phorton1/Arduino-theClock/docs/kicad/pcb1.1/pcb1.1.step

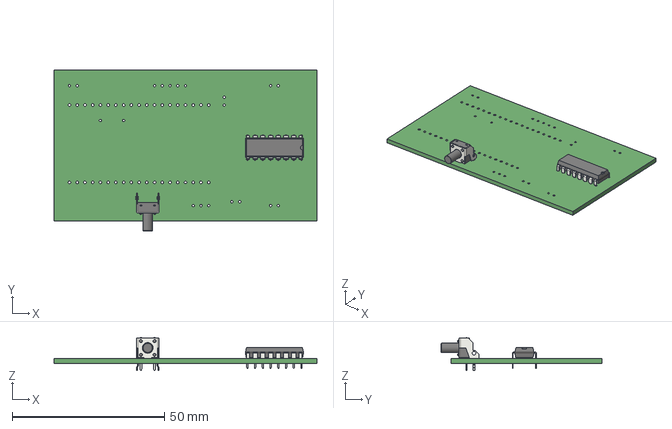
[picture p10: CAD file, 2022-12-11]
docs/kicad/pcb1.1/pcb1.1.step
86.4 x 52.7 x 11.0 mm
