phorton1/Arduino-theClock/docs/kicad/pcb2.0/pcb_v2.step

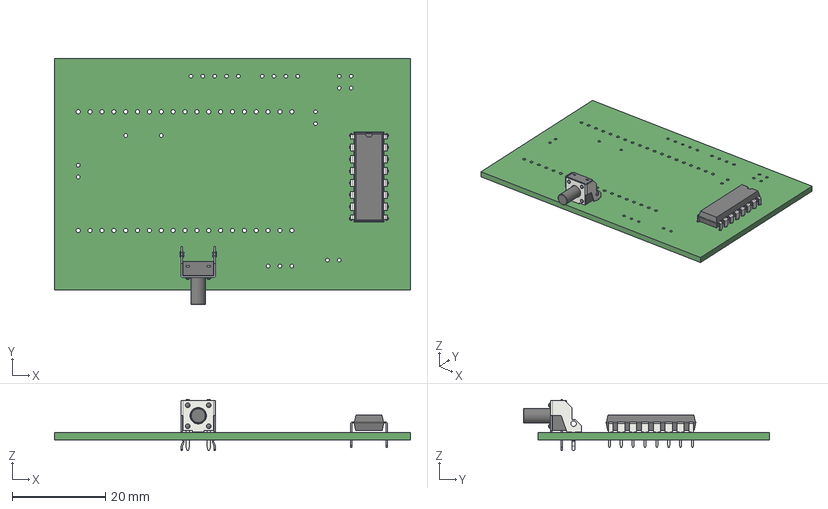
[picture p11: CAD file, 2022-11-30]
docs/kicad/pcb2.0/pcb_v2.step
76.2 x 52.7 x 11.0 mm
