phorton1/Arduino-theClock/docs/version2.0/dxf/minutes_hand.dxf

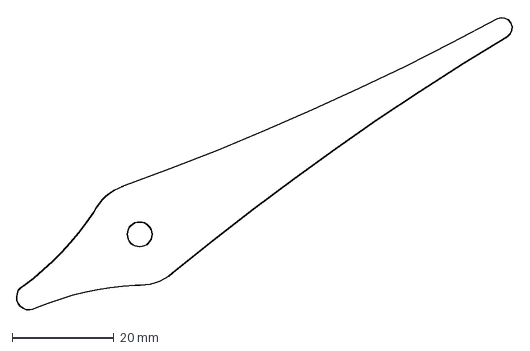
[picture p12: CAD file, 2023-06-12]
docs/version2.0/dxf/minutes_hand.dxf
97.8 x 57.9 mm
