phorton1/Arduino-theClock/docs/version2.0/plastic/coil_set.3mf

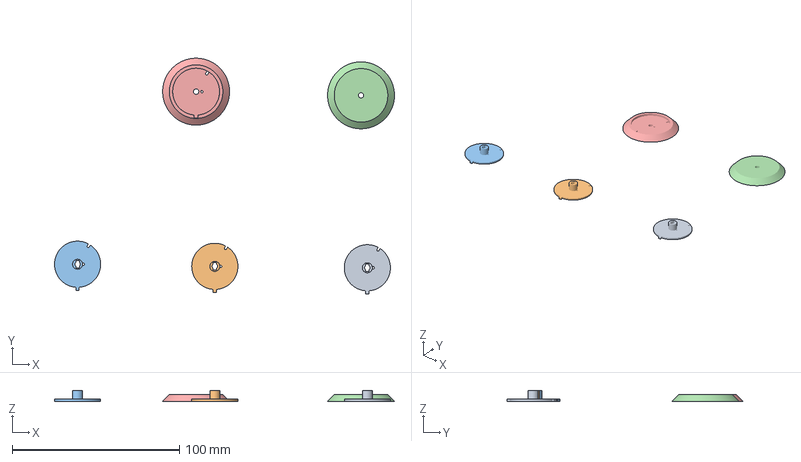
[picture p13: CAD file, 2023-06-12]
docs/version2.0/plastic/coil_set.3mf
203.2 x 140.8 x 6.30 mm
coil_bobbin.stl x 3
coil_tool_front.stl
coil_tool_back.stl
