phorton1/Arduino-theClock/docs/version2.0/dxf/secs_wheel.dxf

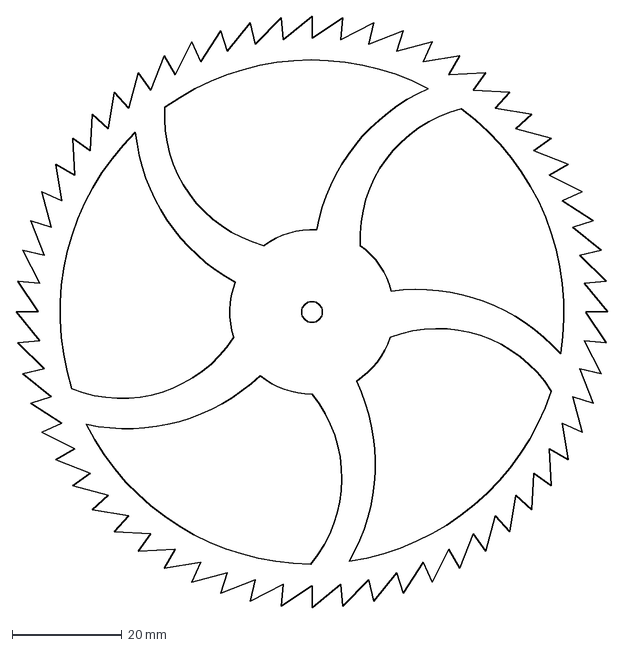
[picture p14: CAD file, 2023-06-12]
docs/version2.0/dxf/secs_wheel.dxf
108.0 x 108.0 mm
