phorton1/Arduino-theClock/docs/version2.0/plastic/plastic_pawl_spacer.stl

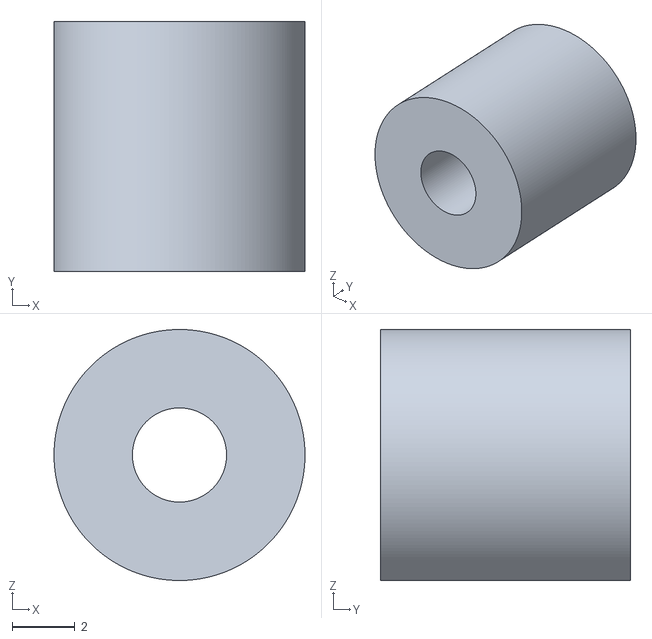
[picture p15: CAD file, 2023-06-12]
docs/version2.0/plastic/plastic_pawl_spacer.stl
8.00 x 7.98 x 8.00
