phorton1/Arduino-theClock/docs/version2.0/dxf/hours_hand.dxf

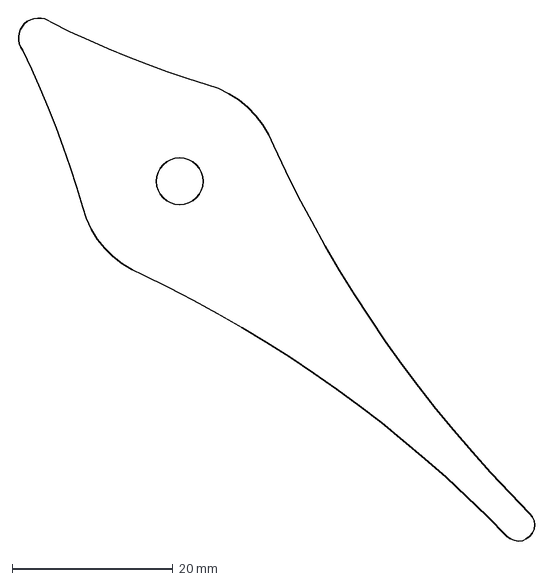
[picture p16: CAD file, 2023-06-12]
docs/version2.0/dxf/hours_hand.dxf
64.5 x 65.4 mm
