phorton1/Arduino-theClock/docs/version2.0/plastic/coil_tool_back.stl

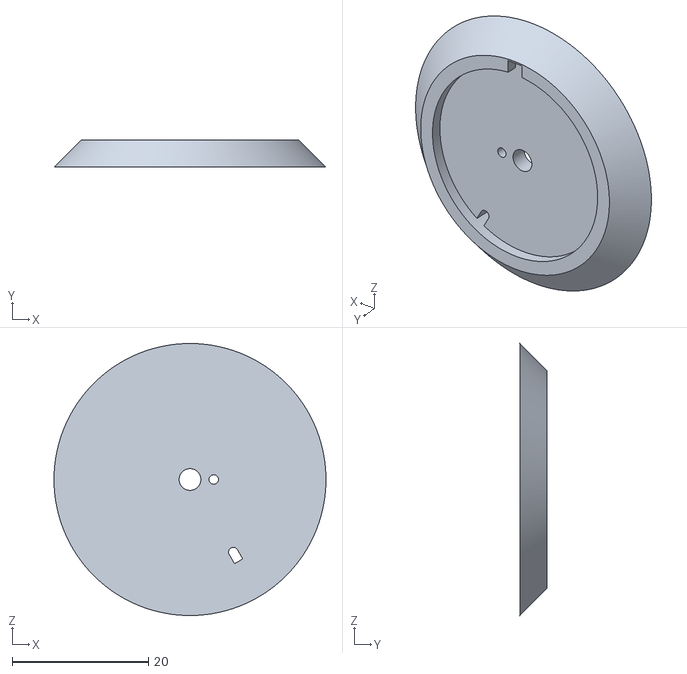
[picture p17: CAD file, 2023-06-12]
docs/version2.0/plastic/coil_tool_back.stl
40.0 x 4.00 x 40.0
