phorton1/Arduino-theClock/docs/version2.0/dxf/seconds_hand.dxf

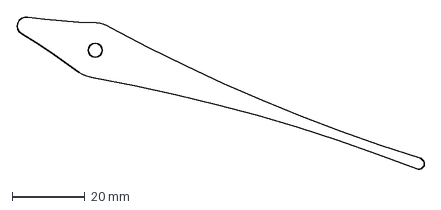
[picture p18: CAD file, 2023-06-12]
docs/version2.0/dxf/seconds_hand.dxf
111.9 x 42.0 mm
