phorton1/Arduino-theClock/docs/version2.0/plastic/coil_bobbin.stl

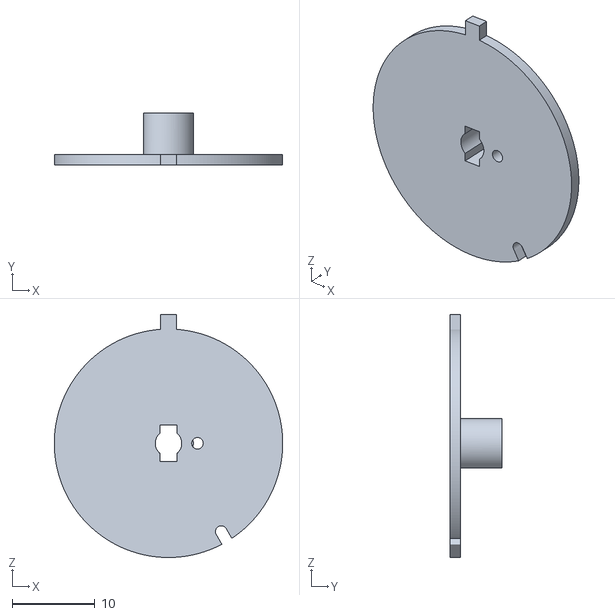
[picture p19: CAD file, 2023-06-12]
docs/version2.0/plastic/coil_bobbin.stl
27.6 x 6.30 x 29.4
