phorton1/Arduino-theClock/docs/version2.0/dxf/arm.dxf

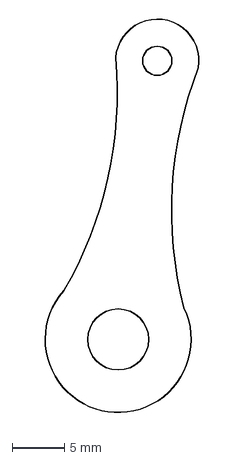
[picture p20: CAD file, 2023-06-12]
docs/version2.0/dxf/arm.dxf
15.5 x 38.8 mm
