phorton1/Arduino-theClock/docs/version2.0/plastic/plastic_box.3mf

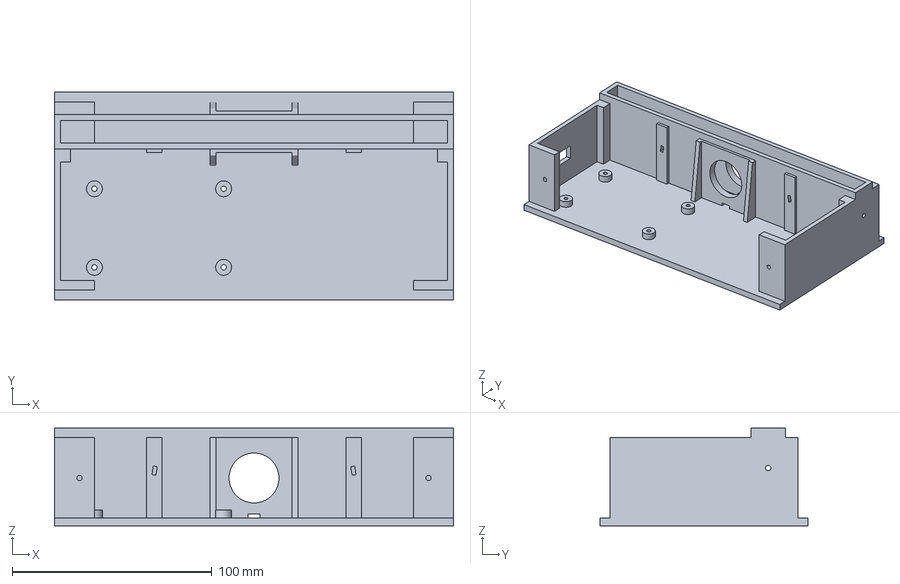
[picture p21: CAD file, 2023-06-12]
docs/version2.0/plastic/plastic_box.3mf
200.0 x 104.3 x 49.0 mm
