phorton1/Arduino-theClock/docs/version2.0/dxf/gear2b_60x2.5735.dxf

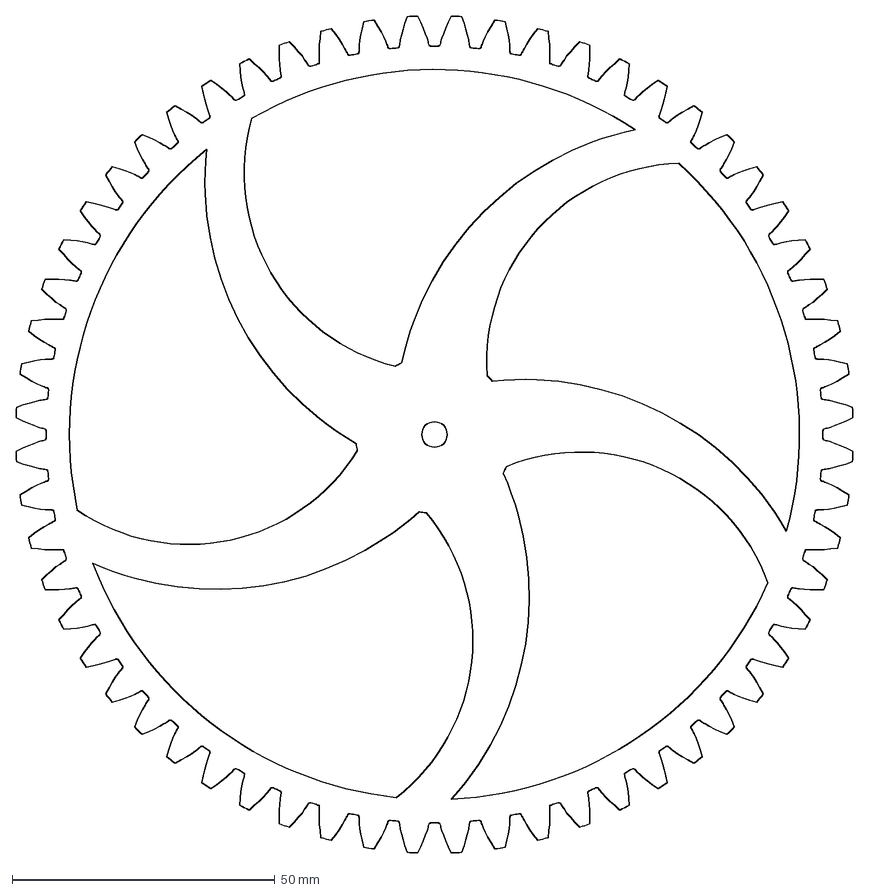
[picture p22: CAD file, 2023-06-12]
docs/version2.0/dxf/gear2b_60x2.5735.dxf
159.4 x 159.4 mm
