phorton1/Arduino-theClock/docs/version2.0/plastic/lens_cap.3mf

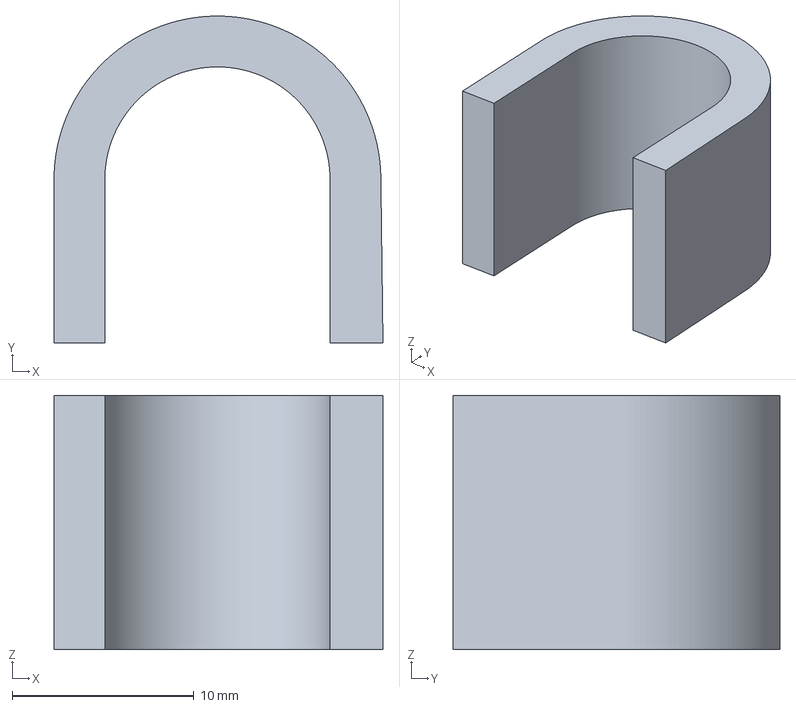
[picture p23: CAD file, 2023-06-12]
docs/version2.0/plastic/lens_cap.3mf
18.1 x 18.0 x 14.0 mm
