phorton1/Arduino-theClock/docs/version2.0/dxf/gear2a_8x2.5735.dxf

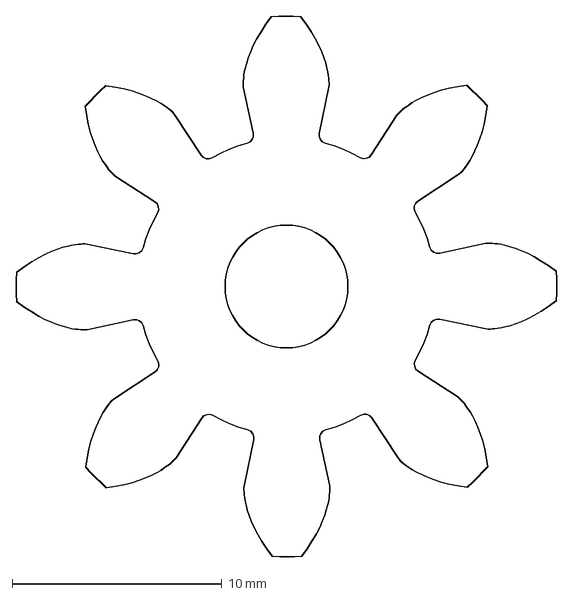
[picture p24: CAD file, 2023-06-12]
docs/version2.0/dxf/gear2a_8x2.5735.dxf
25.8 x 25.8 mm
