phorton1/Arduino-theClock/docs/version2.0/plastic/mag_slider.stl

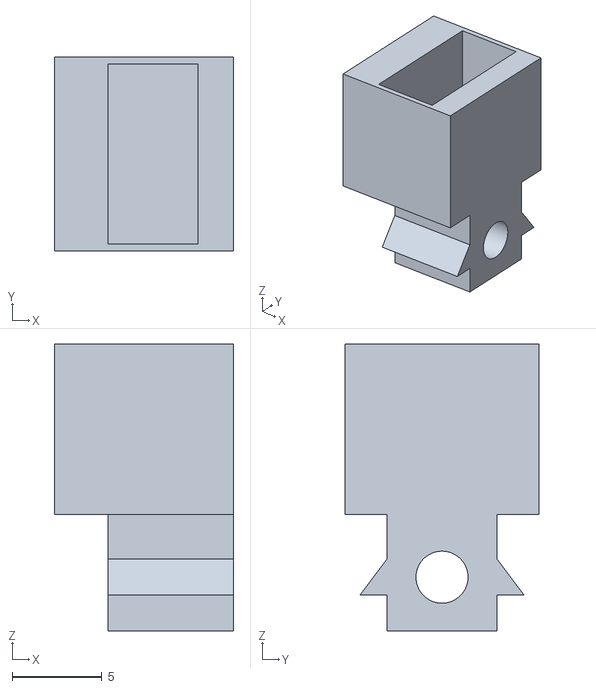
[picture p25: CAD file, 2023-06-12]
docs/version2.0/plastic/mag_slider.stl
10.0 x 10.8 x 16.0
