phorton1/Arduino-theClock/docs/version2.0/dxf/face_numbers.dxf

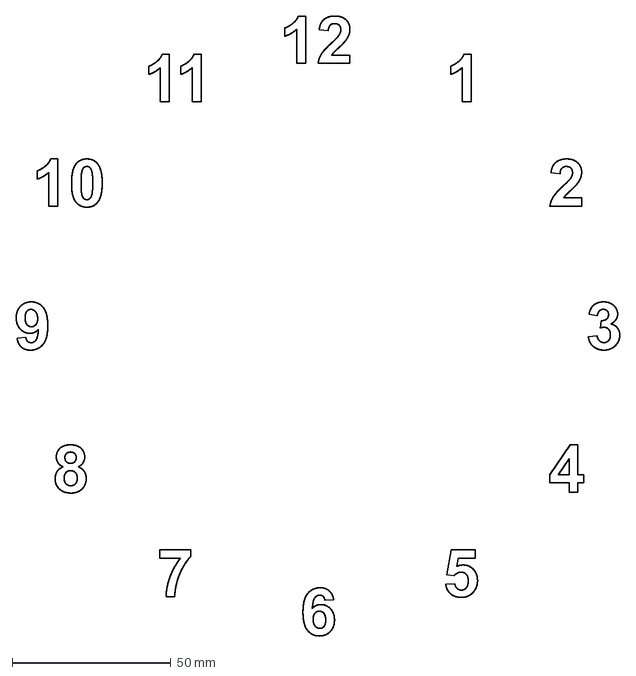
[picture p26: CAD file, 2023-06-12]
docs/version2.0/dxf/face_numbers.dxf
190.0 x 195.2 mm
