phorton1/Arduino-theClock/docs/version2.0/dxf/face.dxf

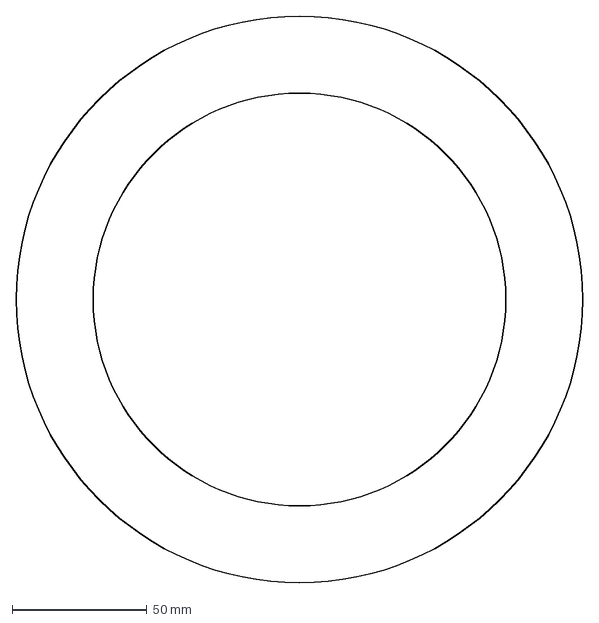
[picture p27: CAD file, 2023-06-12]
docs/version2.0/dxf/face.dxf
210.0 x 210.0 mm
