phorton1/Arduino-theClock/docs/version2.0/plastic/mag_slider_base.stl

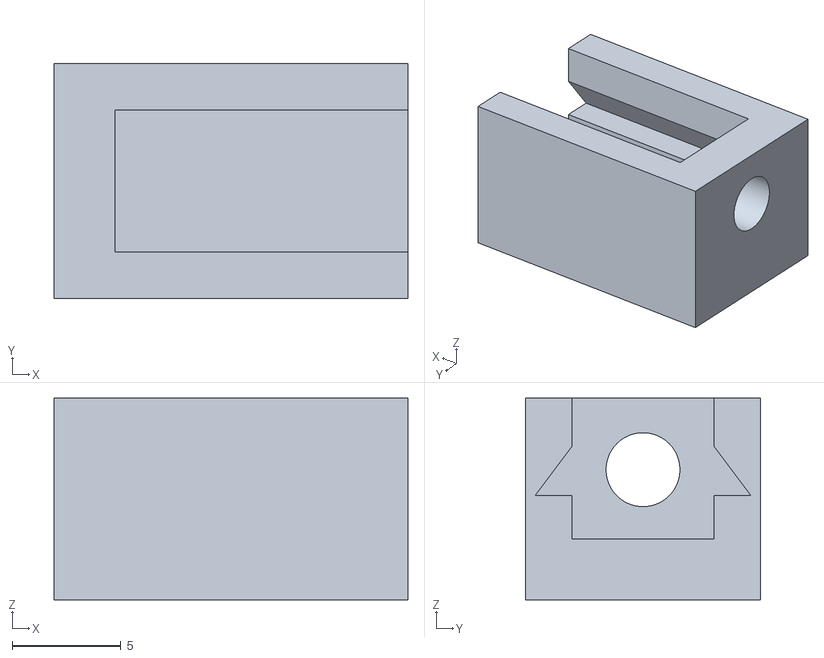
[picture p28: CAD file, 2023-06-12]
docs/version2.0/plastic/mag_slider_base.stl
16.3 x 10.8 x 9.30
