phorton1/Arduino-theClock/docs/version2.0/dxf/pawls.dxf

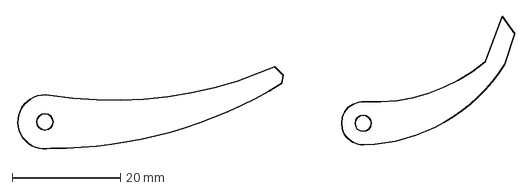
[picture p29: CAD file, 2023-06-12]
docs/version2.0/dxf/pawls.dxf
92.1 x 24.8 mm
