phorton1/Arduino-theClock/docs/version2.0/plastic/mag_slider_set.3mf

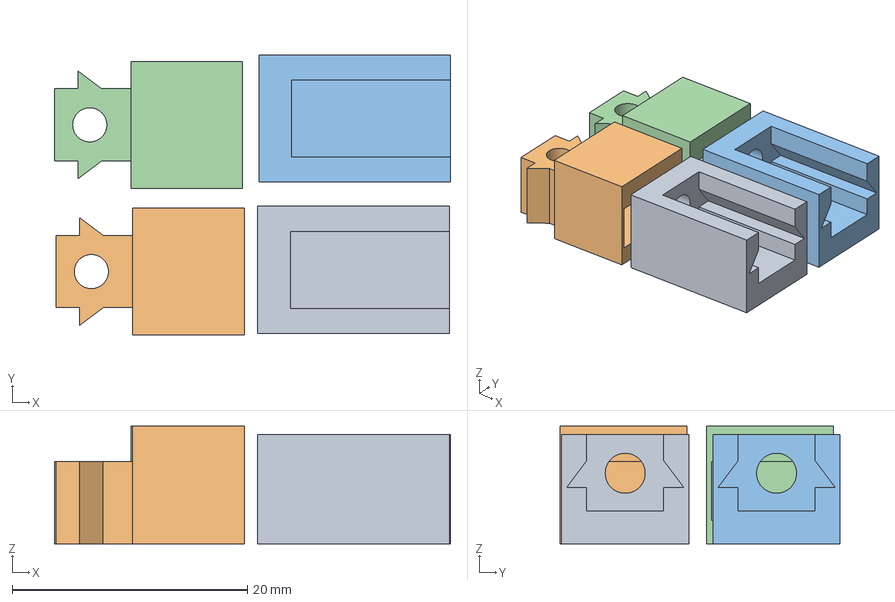
[picture p30: CAD file, 2023-06-12]
docs/version2.0/plastic/mag_slider_set.3mf
33.7 x 23.8 x 10.0 mm
mag_slider_base.stl x 2
mag_slider.stl x 2
