phorton1/Arduino-theClock/docs/version2.0/dxf/gear3a_12x2.9167.dxf

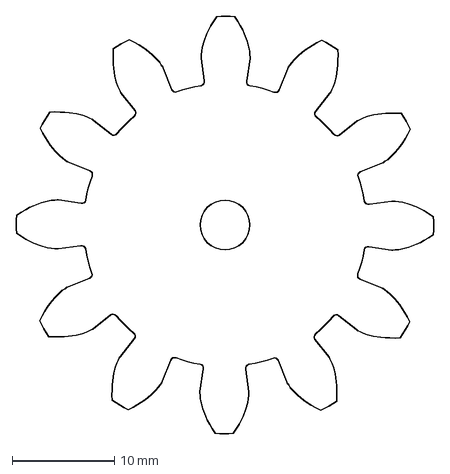
[picture p31: CAD file, 2023-06-12]
docs/version2.0/dxf/gear3a_12x2.9167.dxf
40.9 x 40.9 mm
