phorton1/Arduino-theClock/docs/version2.0/plastic/plastic_bottom_front_spacer.stl

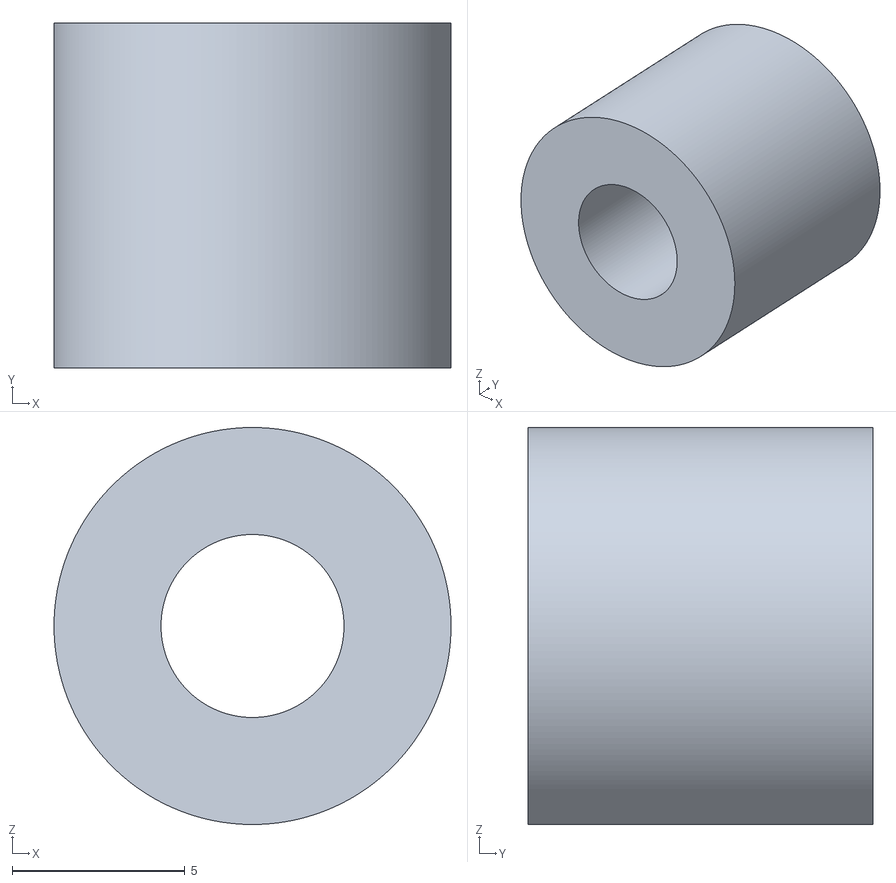
[picture p32: CAD file, 2023-06-12]
docs/version2.0/plastic/plastic_bottom_front_spacer.stl
11.5 x 10.0 x 11.5
