phorton1/Arduino-theClock/docs/version2.0/dxf/gear1b_64x2.4305.dxf

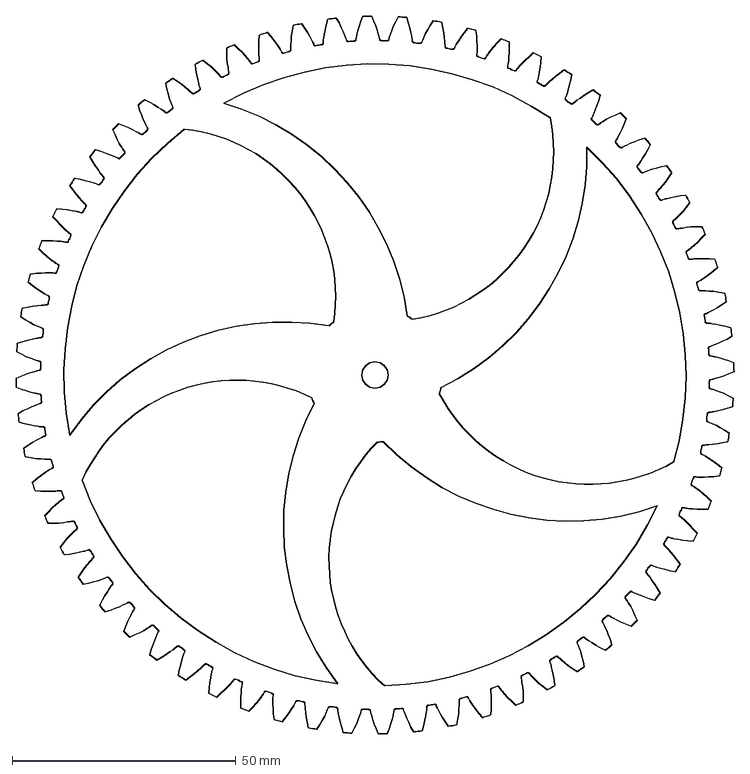
[picture p33: CAD file, 2023-06-12]
docs/version2.0/dxf/gear1b_64x2.4305.dxf
160.4 x 160.4 mm
