phorton1/Arduino-theClock/docs/version2.0/plastic/led_lens.3mf

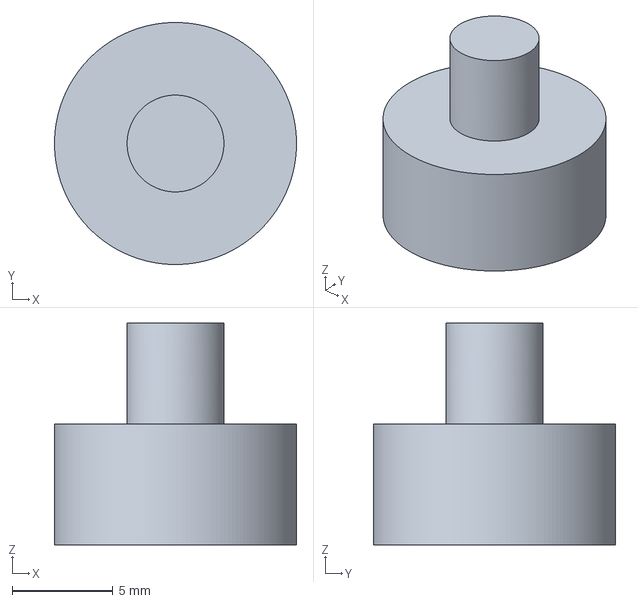
[picture p34: CAD file, 2023-06-12]
docs/version2.0/plastic/led_lens.3mf
12.0 x 12.0 x 11.0 mm
