phorton1/Arduino-theClock/docs/version2.0/plastic/plastic_middle_back_spacer.stl

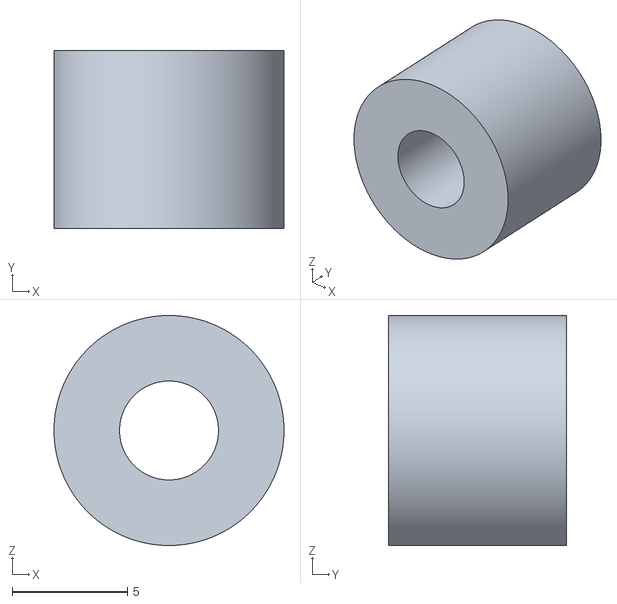
[picture p36: CAD file, 2023-06-12]
docs/version2.0/plastic/plastic_middle_back_spacer.stl
10.00 x 7.73 x 10.00
