phorton1/Arduino-theClock/docs/version2.0/dxf/box_top.dxf

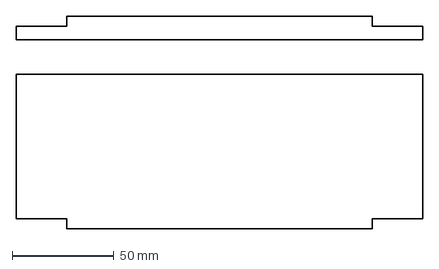
[picture p37: CAD file, 2023-06-12]
docs/version2.0/dxf/box_top.dxf
200.0 x 104.3 mm
