phorton1/Arduino-theClock/docs/version2.0/dxf/gear4a_16x2.7344.dxf

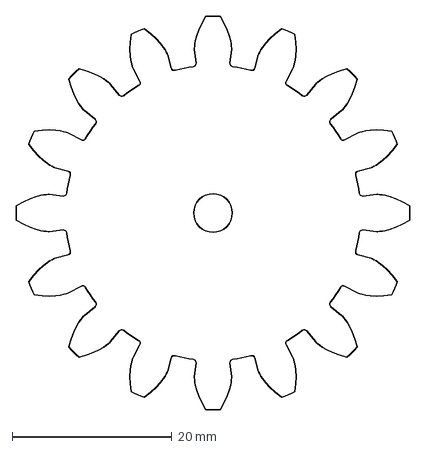
[picture p38: CAD file, 2023-06-12]
docs/version2.0/dxf/gear4a_16x2.7344.dxf
49.2 x 49.2 mm
