phorton1/Arduino-theClock/docs/version2.0/plastic/plastic_middle_front_spacer.stl

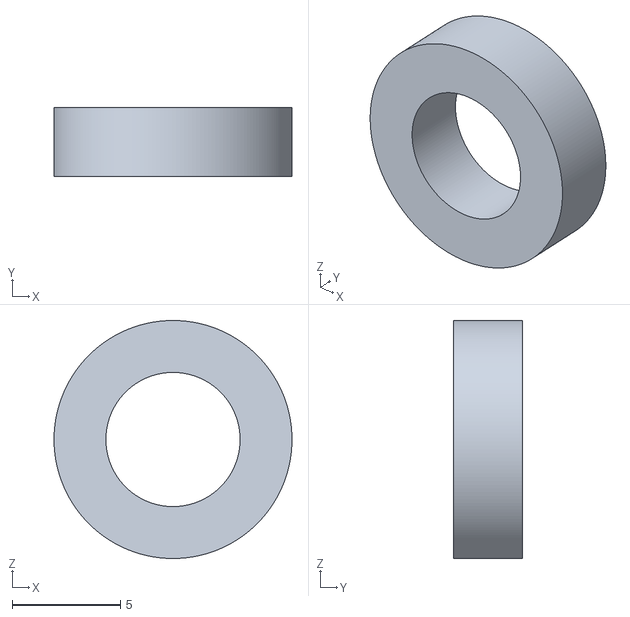
[picture p39: CAD file, 2023-06-12]
docs/version2.0/plastic/plastic_middle_front_spacer.stl
11.0 x 3.18 x 11.0
