phorton1/Arduino-theClock/docs/version2.0/dxf/front.dxf

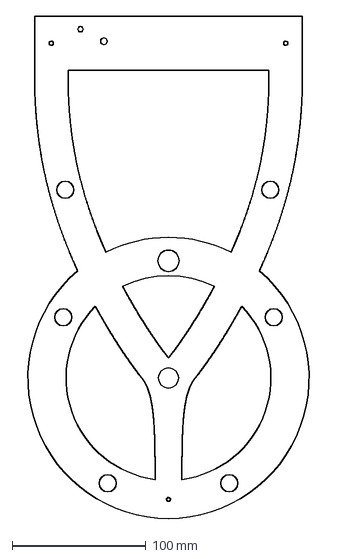
[picture p40: CAD file, 2023-06-12]
docs/version2.0/dxf/front.dxf
227.5 x 375.0 mm
