phorton1/Arduino-theClock/docs/version2.0/dxf/back.dxf

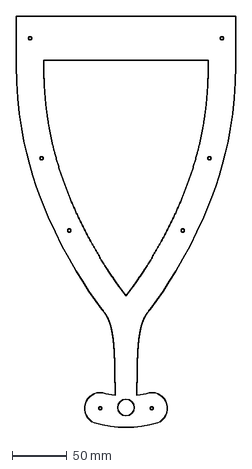
[picture p41: CAD file, 2023-06-12]
docs/version2.0/dxf/back.dxf
200.0 x 376.3 mm
