phorton1/Arduino-theClock/docs/version2.0/dxf/gear3b_48x2.9167.dxf

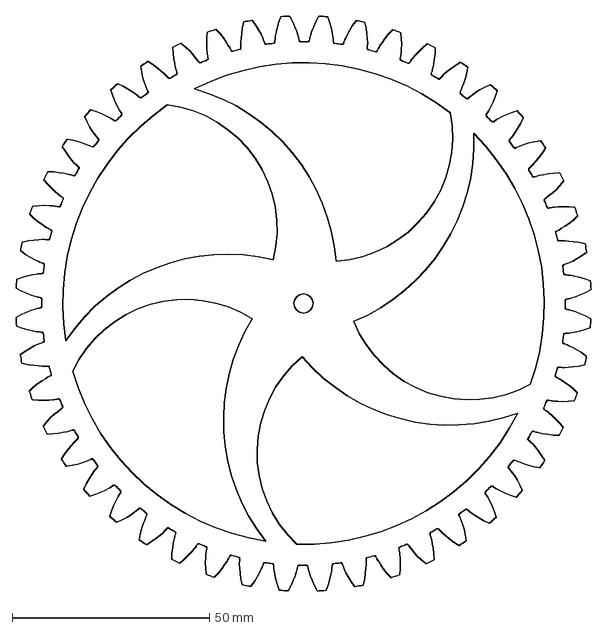
[picture p43: CAD file, 2023-06-12]
docs/version2.0/dxf/gear3b_48x2.9167.dxf
145.7 x 145.7 mm
