phorton1/Arduino-theClock/docs/version2.0/dxf/pendulum.dxf

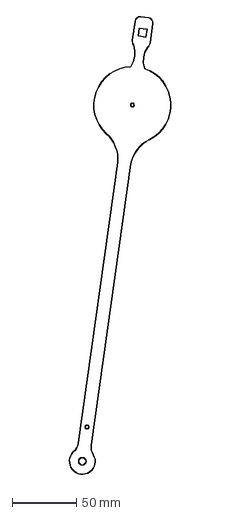
[picture p44: CAD file, 2023-06-12]
docs/version2.0/dxf/pendulum.dxf
80.8 x 357.6 mm
