phorton1/Arduino-theClock/docs/version2.0/dxf/gear1a_8x2.4305.dxf

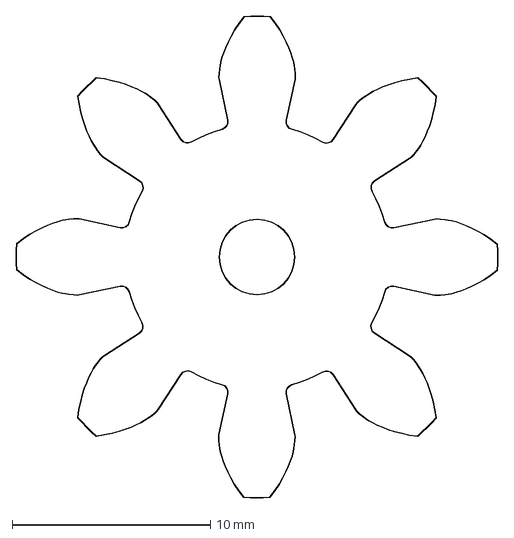
[picture p45: CAD file, 2023-06-12]
docs/version2.0/dxf/gear1a_8x2.4305.dxf
24.3 x 24.3 mm
