phorton1/Arduino-theClock/docs/version2.0/dxf/gear4b_48x2.7344.dxf

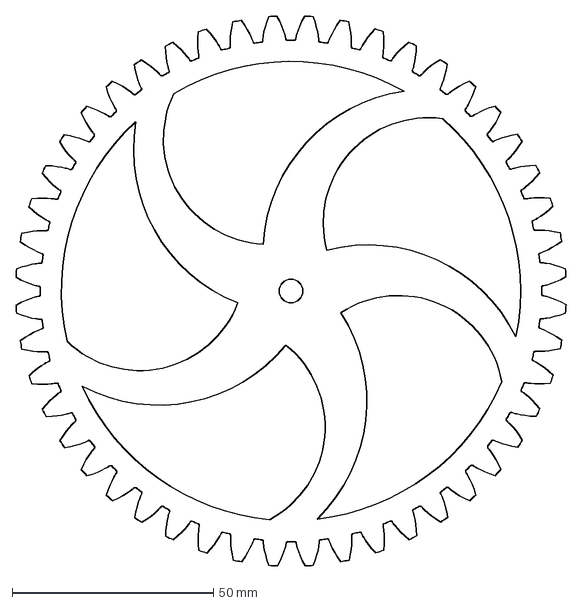
[picture p46: CAD file, 2023-06-12]
docs/version2.0/dxf/gear4b_48x2.7344.dxf
136.6 x 136.6 mm
