phorton1/Arduino-theClock/(list of files, cad)

Other CAD files:
docs/fusion/CoilWinder.f3d
docs/fusion/clock1.1.f3d
docs/version1.0/dxf/arm.dxf
docs/version1.0/dxf/back.dxf
docs/version1.0/dxf/box_back.dxf
docs/version1.0/dxf/box_bottom.dxf
docs/version1.0/dxf/box_front.dxf
docs/version1.0/dxf/box_left.dxf
docs/version1.0/dxf/box_mag_holder_back.dxf
docs/version1.0/dxf/box_mag_holder_front.dxf
docs/version1.0/dxf/box_right.dxf
docs/version1.0/dxf/box_shims.dxf
docs/version1.0/dxf/box_top.dxf
docs/version1.0/dxf/front.dxf
docs/version1.0/dxf/gear1a.dxf
docs/version1.0/dxf/gear1b.dxf
docs/version1.0/dxf/gear2a.dxf
docs/version1.0/dxf/gear2b.dxf
docs/version1.0/dxf/gear3a.dxf
docs/version1.0/dxf/gear3b.dxf
docs/version1.0/dxf/gear4a.dxf
docs/version1.0/dxf/gear4b.dxf
docs/version1.0/dxf/hour_hand.dxf
docs/version1.0/dxf/hours_spacer.dxf
docs/version1.0/dxf/mag_holder_front_r12_from_libracad.dxf
docs/version1.0/dxf/middle.dxf
docs/version1.0/dxf/minute_hand.dxf
docs/version1.0/dxf/pendulum.dxf
docs/version1.0/dxf/sec_wheel.dxf
docs/version1.0/dxf/second_hand.dxf
docs/version1.0/plastic/bobbin1.stl
docs/version1.0/plastic/bobbin2.stl
docs/version1.0/plastic/bobbin_set.3mf
docs/version1.0/plastic/mag_base.stl
docs/version1.0/plastic/mag_slider.stl
docs/version1.0/plastic/mag_spring.3mf
docs/version1.0/plastic/pcb_base.3mf
docs/version1.0/plastic/pcb_base.stl
docs/version1.0/plastic/tool1.stl
docs/version1.0/plastic/tool2.stl
docs/version1.0/plastic/tool_set.3mf
docs/version1.1/dxf/box_bottom.dxf
docs/version1.1/dxf/gear2b.dxf
docs/version1.1/dxf/gear3a.dxf
docs/version1.1/dxf/gear3a_for_bearing.dxf
docs/version1.1/dxf/mag_holder_front.dxf
docs/version1.1/plastic/one_way_bearing_for_clock_one.3mf
docs/version1.1/plastic/one_way_bearing_for_clock_one.stl
docs/version2.0/dxf/stops_spacers_and_washers/arm3_stop_3x8.dxf
docs/version2.0/dxf/stops_spacers_and_washers/arm_washer_6x11.dxf
docs/version2.0/dxf/stops_spacers_and_washers/back_top_stop_6x11.dxf
docs/version2.0/dxf/stops_spacers_and_washers/gear1_spacer_6x30.dxf
docs/version2.0/dxf/stops_spacers_and_washers/gear2_spacer_5x30.dxf
docs/version2.0/dxf/stops_spacers_and_washers/gear3_spacer_5x27.dxf
docs/version2.0/dxf/stops_spacers_and_washers/gear4_spacer_thick_6x26.dxf
docs/version2.0/dxf/stops_spacers_and_washers/hours_stop_6x11.dxf
docs/version2.0/dxf/stops_spacers_and_washers/pendulum_holder_6x20.dxf
docs/version2.0/dxf/stops_spacers_and_washers/pendulum_washer_thick_6x11.dxf
docs/version2.0/dxf/stops_spacers_and_washers/sec_wheel_spacer_4x28.dxf
docs/version2.0/plastic/coil_washer.stl
docs/version2.0/plastic/coil_washers.3mf
docs/version2.0/plastic/led_lens.stl
docs/version2.0/plastic/lens_cap.stl
docs/version2.0/plastic/plastic_box.stl
docs/version2.0/plastic/plastic_washers.3mf
