phorton1/Arduino-theClock/docs/kicad/pcb1.1/pcb.kicad_pcb

## KiCad design docs/kicad/pcb1.1/pcb.kicad_pcb (2022-12-11)

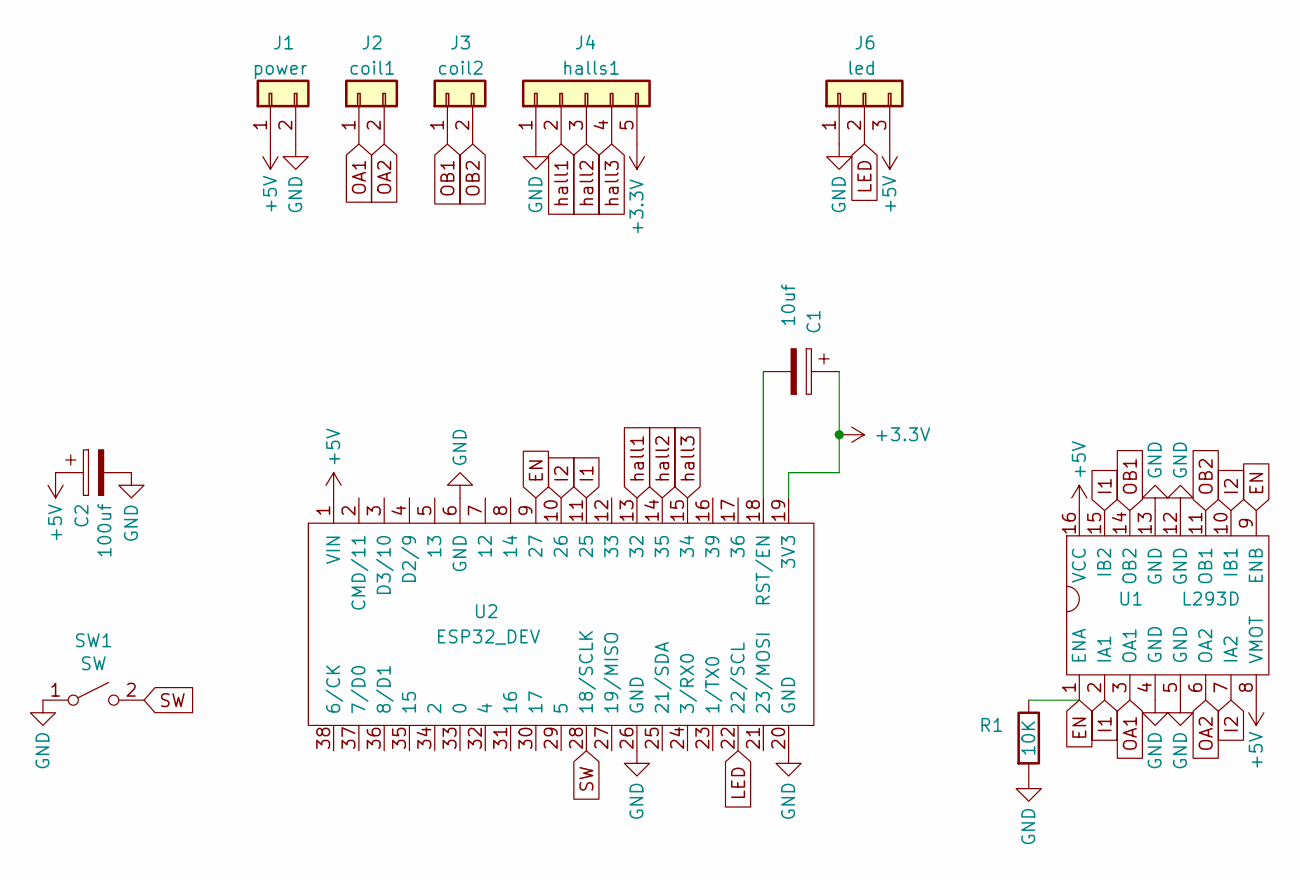
[picture p47: schematic pcb.sch]

Parts:
C1: 10uf; my2pin
C2: 100uf; my2pin
J1: power; my2pin
J2: coil1; my2pin
J3: coil2; my2pin
J4: halls1; my5Pin
J6: led; my3pin
R1: 10K; myResistor
SW1: SW; right_angle_button
U1: L293D; myDip16
U2: ESP32_DEV; ESP32-DEV

Connections:
+3V3: C1.1, J4.5, U2.19 (3V3)
+5V: C2.1, J1.1, J6.3, U1.8 (VMOT), U1.16 (VCC), U2.1 (VIN)
EN: R1.1, U1.1 (ENA), U1.9 (ENB), U2.9 (27)
GND: C2.2, J1.2, J4.1, J6.1, R1.2, SW1.1 (A), U1.4 (GND), U1.5 (GND), U1.12 (GND), U1.13 (GND), U2.6 (GND), U2.20 (GND), U2.26 (GND)
I1: U1.2 (IA1), U1.15 (IB2), U2.11 (25)
I2: U1.7 (IA2), U1.10 (IB1), U2.10 (26)
LED: J6.2, U2.22 (22/SCL)
unnamed: C1.2, U2.18 (RST/EN)
OA1: J2.1, U1.3 (OA1)
OA2: J2.2, U1.6 (OA2)
OB1: J3.1, U1.14 (OB2)
OB2: J3.2, U1.11 (OB1)
SW: SW1.2 (B), U2.28 (18/SCLK)
hall1: J4.2, U2.13 (32)
hall2: J4.3, U2.14 (35)
hall3: J4.4, U2.15 (34)

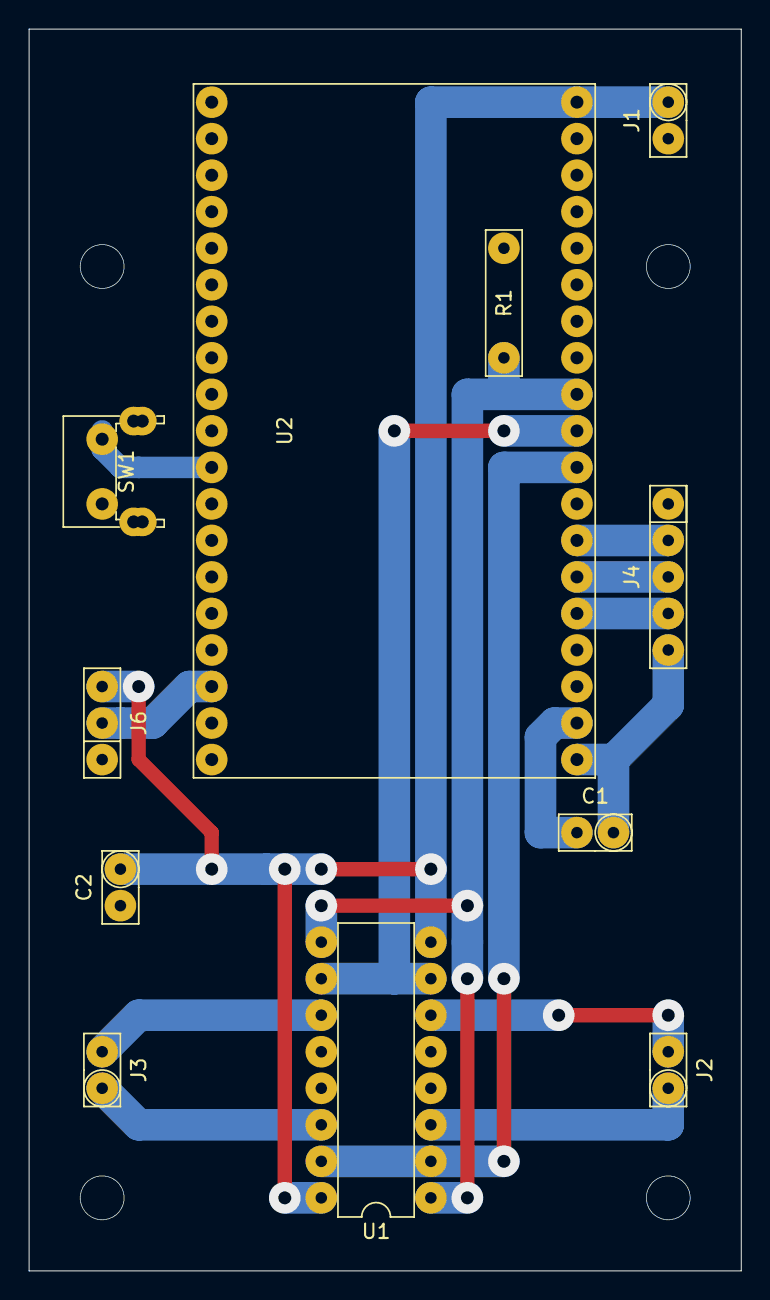
[picture p48: board docs/kicad/pcb1.1/pcb.kicad_pcb from above]

Board: 2 copper layers, 49.5 x 86.4 mm, 11 parts (0 on the bottom side), 16 nets.
