phorton1/Arduino-theClock/docs/kicad/pcb1.0/pcb.kicad_pcb

## KiCad design docs/kicad/pcb1.0/pcb.kicad_pcb (2022-11-27)

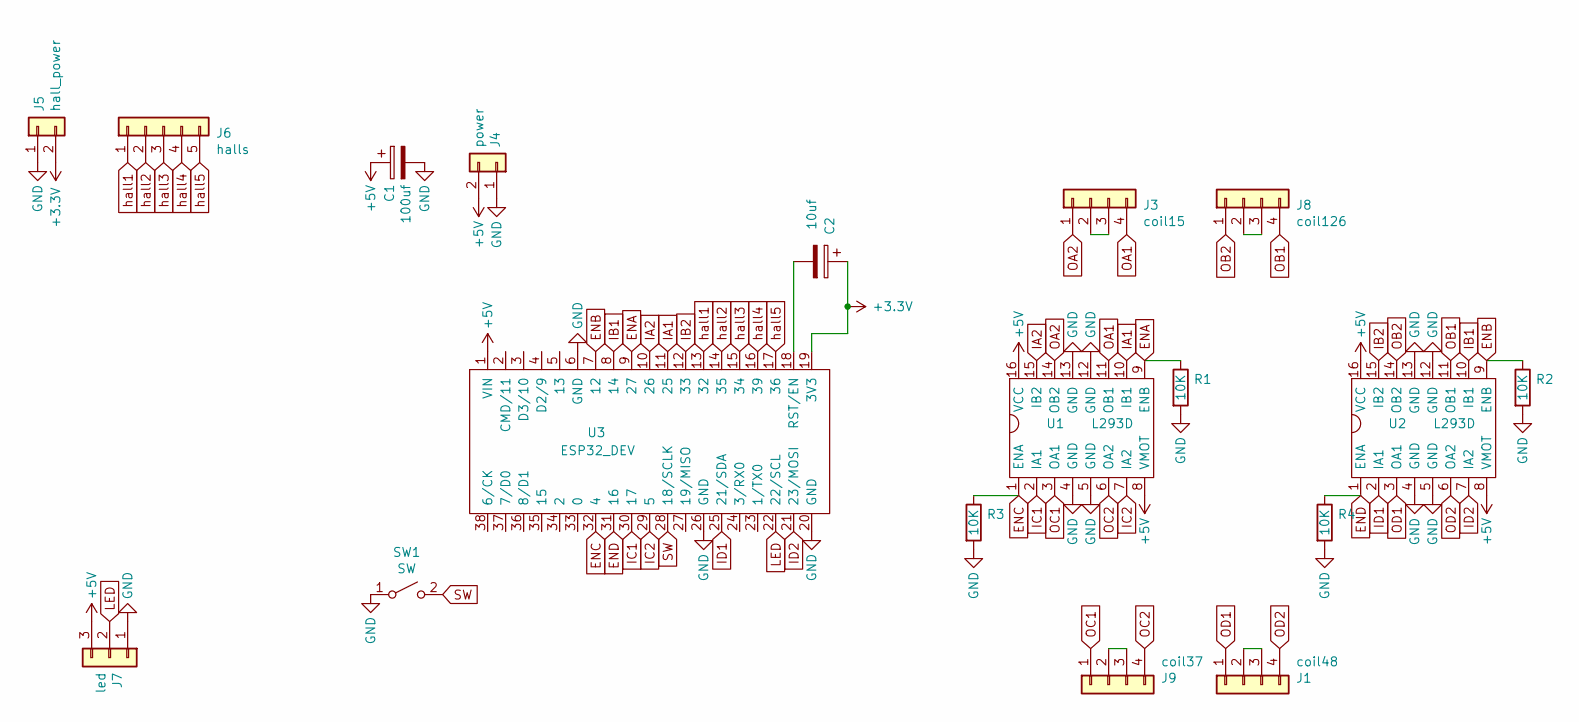
[picture p49: schematic pcb.sch]

Parts:
C1: 100uf; my2pin
C2: 10uf; my2pin
J1: coil48; my4pin
J3: coil15; my4pin
J4: power; my2pin
J5: hall_power; my2pin
J6: halls; my5Pin
J7: led; my3pin
J8: coil126; my4pin
J9: coil37; my4pin
R1, R2, R3, R4: 10K; myResistor
SW1: SW; right_angle_button
U1, U2: L293D; myDip16
U3: ESP32_DEV; ESP32-DEV

Connections:
+3V3: C2.1, J5.2, U3.19 (3V3)
+5V: C1.1, J4.2, J7.3, U1.8 (VMOT), U1.16 (VCC), U2.8 (VMOT), U2.16 (VCC), U3.1 (VIN)
ENA: R1.1, U1.9 (ENB), U3.9 (27)
ENB: R2.1, U2.9 (ENB), U3.7 (12)
ENC: R3.1, U1.1 (ENA), U3.32 (4)
END: R4.1, U2.1 (ENA), U3.31 (16)
GND: C1.2, J4.1, J5.1, J7.1, R1.2, R2.2, R3.2, R4.2, SW1.1 (A), U1.4 (GND), U1.5 (GND), U1.12 (GND), U1.13 (GND), U2.4 (GND), U2.5 (GND), U2.12 (GND), U2.13 (GND), U3.6 (GND), U3.20 (GND), U3.26 (GND)
IA1: U1.10 (IB1), U3.11 (25)
IA2: U1.15 (IB2), U3.10 (26)
IB1: U2.10 (IB1), U3.8 (14)
IB2: U2.15 (IB2), U3.12 (33)
IC1: U1.2 (IA1), U3.30 (17)
IC2: U1.7 (IA2), U3.29 (5)
ID1: U2.2 (IA1), U3.25 (21/SDA)
ID2: U2.7 (IA2), U3.21 (23/MOSI)
LED: J7.2, U3.22 (22/SCL)
unnamed: C2.2, U3.18 (RST/EN)
unnamed: J1.2, J1.3
unnamed: J3.2, J3.3
unnamed: J8.2, J8.3
unnamed: J9.2, J9.3
OA1: J3.4, U1.11 (OB1)
OA2: J3.1, U1.14 (OB2)
OB1: J8.4, U2.11 (OB1)
OB2: J8.1, U2.14 (OB2)
OC1: J9.1, U1.3 (OA1)
OC2: J9.4, U1.6 (OA2)
OD1: J1.1, U2.3 (OA1)
OD2: J1.4, U2.6 (OA2)
SW: SW1.2 (B), U3.28 (18/SCLK)
hall1: J6.1, U3.13 (32)
hall2: J6.2, U3.14 (35)
hall3: J6.3, U3.15 (34)
hall4: J6.4, U3.16 (39)
hall5: J6.5, U3.17 (36)

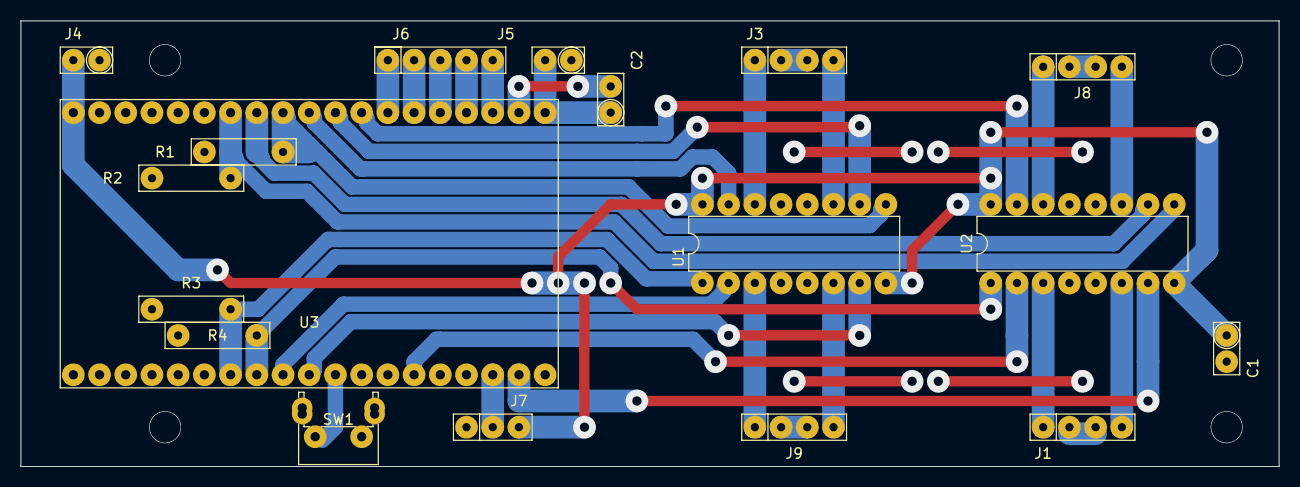
[picture p50: board docs/kicad/pcb1.0/pcb.kicad_pcb from above]

Board: 2 copper layers, 121.9 x 43.2 mm, 18 parts (0 on the bottom side), 35 nets.
