phorton1/Arduino-theClock/(commit log)

2022-11-30 prep for V2 (single coil) circuit board by duplicating and moving kicad stuff into separate folders
    [pcb.kicad_pcb, pcb.sch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]
2022-12-02 updated to V1.1 - single coil and 3 hall sensors
2022-12-11 renamed pcb 2.0 to 1.1 - WIP
    [pcb.kicad_pcb, pcb.sch, pcb1.1.step]
2022-12-11 moved pcb1.1 mounting hole
    [pcb.kicad_pcb]
2022-12-14 finished pcb
    [pcb-B_Cu.gbr, pcb-B_Mask.gbr, pcb-Eco1_User.gbr, pcb-Edge_Cuts.gbr, pcb.drl, pcb.sorted.drl]
2022-12-18 CLOCK 2.0 - initial changes: version number, hall calibrations
2022-12-20 implemented button control and led pixel feedback
2023-04-19 diagram v1.3 (v1.1 plus v3 sensor & software)
    [pcb.sch, pcb1.1wV3_sensor.kicad_pcb]
2023-06-12 initial commit of documentation WIP
    [CoilWinder.f3d, arm.dxf, arm3_stop_3x8.dxf, arm_washer_6x11.dxf, back.dxf, back_top_stop_6x11.dxf, bobbin1.stl, bobbin2.stl]
2023-06-16 added link to new Arduino-CoilWindingMachine repository
2024-02-20 normalize myIOT data directories against Arduino/Libraries myIOT/data master
2024-09-21 submodule(data) auto_commit(83767cf1) Added a Widget tab to the main myIOT webpage; added jqplot CSS and JS files; wrote iotPlot.js prototype of charting within a "widget" - see fridgeController chec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
2024-09-25 submodule(data) auto_commit(331f60b7) refined myIOT plotter with LEGENDS and using device specific PLOT_TYPES if available; theClock3 implementation of PLOT_CYCLES and PLOT_WAVES
2024-09-29 submodule(data) auto_commit(416ed000) added prototype bilgeAlarm jqPlot Widget using added "alt_data_format" and custom chart_header and chart_data code in onCustomLink(). modified myIOT/data index.h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
2024-10-21 submodule(data) auto_commit(b811e3f8) move generic uiButtons to myIOTButtons; implement initial tempController uiScreen and PCB board(s)
2025-12-15 submodule(data) auto_commit(b649fc3a) iotChart.js - added scheme for setting device specific series colors
2025-12-18 submodule(data) auto_commit(1adaeb45) reworked iotChart.js incremental update scheme starting with Arduino-boat-drainPump
2025-12-18 submodule(data) auto_commit(b6ac0c88) starting in Arduino-boat-arirco, major rework of iotChart.js and how charts are implemented - use common chart.html instead of specific/extra_data/device_chart.h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
2025-12-18 submodule(data) auto_commit(a4e2ed81) change chart.html and iotChart.js to use and remove style "degree_hidden" for devices that chart things with degrees
2026-02-22 submodule(data) auto_commit(37a6a76c) added framework for chart.html to pass "data_name" to allow multiple charts per device; ALSO store most recent chart period in browser storage
2026-03-05 submodule(data) auto_commit(ecc76888) update myIOT data submodule readme.md to remove forward references to actual implmented device repos
2026-04-04 submodule(data) auto_commit(de0689cf) disable Scan/Delete endpoints and just View data records for devices that have graphs, but no SD card
2026-06-28 submodule(data) auto_commit(eadab9ea) added myIOTDataLog type LOG_COL_TYPE_INT16_10 to support volts (fridgeController)
